waleed-iftikhar/Baby-stroller-using-PIC-16F877a-microcontroller/README.txt

Goal of this project is make baby strollers intelligent.

Functionality

	Stroller senses the presence of stroller driver (parents / supervisor)
	Send status of stroller to mobile app using bluetooth
	Control brakes according to the situation.
