waleed-iftikhar/Baby-stroller-using-PIC-16F877a-microcontroller/Project_Description.docx

- High Level Block Diagram

High level block diagram describes the basic organization of the project. The process of creating the block diagram started off at multiple low level need based block diagrams. Team divided the project into four sections, researched the types of interface needed for each section. After each diagram, all the block diagrams were combined into a high level block diagram, shown in Figure 5. It helped in gaining insight on the project. Four sections of the project are

Inputs: It consists of Driver, Baby and Waist-belt sensors. These sensors provide input to the microcontroller.

Output: It consists of brakes that are controlled by the microcontroller.

Wireless medium: It provides connectivity between microcontroller and the smartphone.

Smartphone App: It displays the status of stroller on the smartphone.

Figure 5: High Level Block Diagram

- Detailed Design

The detailed design process behind the Intelligent Baby Stroller is discussed in details in the upcoming sections. The sections, hardware, software, and engineering analysis, are the cornerstones of the Intelligent Baby Stroller. In these sections detailed explanation of every aspect of the design is provided.

- Hardware

As illustrated in Figure 5 design team divided the project into multiple subcategories. This approach led to the successful completion of project with in the schedule. Every portion of the project is discussed in detail in the following subsections.

- Driver sensing

Flexi-force sensor is very flexible and it can be easily mounted on the handle of the stroller. Its resistance changes inversely with the applied pressure. Its resistance also changes by bending the sensing area. In the absence of any sort of force the resistance of the flexi-force sensor is greater than 10 M ohm [13]. When we mount the flexi-force sensor on the handle of the stroller, its resistance drops to the 1 M ohm. This is the inherent change in resistance of the flexi-force sensor, when mounted on the handle of the stroller. When someone places hands on the handle of the stroller, the resistance of flexi-force sensor reduces inversely with the applied pressure. Design team used this phenomenon as an advantage. The circuit of the driver sensor consists of the operational amplifier and a combination of resistors as shown in the Figure 10. In this circuit the op-amp is utilized as the comparator. It keeps check of the input voltages applied at the +ive and –ive input terminals. When the force is applied at the sensing area of the flexi-force sensor, the voltage across the +ive input terminal increases. When the voltage across +ive input terminal becomes greater than the voltage across –ive input terminal, the op-amp pulls the output pin high and vice versa. In other words, when the output of the circuit is high, it means the driver is present and when the output of the sensing circuit is low, it means the driver is absent. Two sensors are mounted on the handle of the stroller. Each sensor has its own circuit. The outputs of both op-amps is connected to the pins RB4 and RB5 of the PIC16F877A. These pins are part of PORTB of the microcontroller. These pins of microcontroller are configured as interrupts. Microcontroller responds to the every change of the input signal instantly.

Figure 10: Driver Sensing Circuit

- Baby Sensing

Design team used three Force Sensitive Resistor (FSR) for baby sensing. These sensors are mounted at the appropriate places on the seat of the stroller. Circuit of the baby sensing circuit is shown in the Figure 11. Output of the baby sensing circuit is treated as the analogue signal. As the force applied to the sensing area of the FSR is increased the output voltage of the baby sensing circuit increases. The output voltages of the baby sensing circuit are fed to the Analogue to Digital converting (ADC) Port of the microcontroller. Microcontroller reads the output of every sensor after a short time interval and makes decision accordingly about the presence of baby.

Figure 11: Baby Sensing Circuit

- Waist Belt sensing

Design team came up with the very smart, simple and cost effective idea for sensing the status of waist belt. Waist belt sensing circuit consists of a push button and a resistor as shown in Figure 12 Push button is mounted inside the buckle of the waist belt. When the waist belt is locked, push button is in closed condition and the output is high signal. When the waist belt is open, push button is in the open condition and output is low signal. Both the high and low signals contain information. So team decided to keep track of the signal. The output of the waist belt sensor is connected to the “Signal Change Interrupt” of the microcontroller, just like the driver sensing.

Figure 12: Waist Belt Sensing Circuit

- Brakes

Design team spent a lot of time to come up with the economical and power efficient braking mechanism. The team analyzed the manual braking mechanism of the stroller and decided to manipulate it electronically. In this way cost can be reduced. The inner side of the stroller’s wheel is specially designed. Wheel has inner linings that are separated by angle 45o. When we apply brakes the wedge shaped plastic body gets stuck between the inner linings of the wheels thus restricting the movement of wheels. The team decided to use geared DC motors [16] along with the limit switches to control the movement of the wedge shaped body. Braking mechanism is illustrated in Figure 13.

Figure 13: Braking Mechanism

A pair of limit switches play very important role in controlling the rotation of motor. They act as feedback and inform the microcontroller about the status of brakes. It is illustrated in Figure 14. There are two limit switches for each wheel. One is limit switch senses that the brake is locked or not and other limit switch senses that the brake has properly unlocked or not.

Figure 14: Limit Switch Mechanism

Design Team used the L298 chip to control the direction of rotation of the motors. It is dual H-bridge IC. It is a high voltage, high current dual full-bridge driver designed to accept standard TTL logic levels and drive inductive loads such as relays, solenoids, DC and stepping motors. Two enable inputs are provided to enable or disable the device independently of the input signals [15]. Circuit of L298 is shown in the Figure 15. Design team was very concerned about the back emf phenomenon because motors operate in both directions, possibly at high switching rate. In order to counter the back emf, team used 1N4004 diodes in the circuit. These diodes can withstand large reverse voltages and have very high switching speed [24].

Designed braking mechanism has following features,

- It can be operated at 6-12VDC.
- Economical and components are easily available.
- It consumes very low electrical power. Thus increasing the life cycle of battery.
- It needs electric current only when brakes are to be locked or unlocked.

Figure 15: Motor Driver Circuit

- Power supply

The designed circuit operates at two different voltage levels. Microcontroller and sensors are operating at 5V, whereas the motor driver circuit needs more than 6V to operate normally. In order to resolve this issue, design team decided to use 5V voltage regulator LM7805. It can deliver up to 1.5 A of output current. The internal current-limiting and thermal-shutdown features of these regulators essentially make them immune to overload. It has internal short circuit current limiting and high power dissipation capabilities. [17]. Pin diagram of LM7805 is shown in the Figure 16.

Figure 16: Pin Diagram of LM7805

Noise is the inherent feature of a system, especially in the motor driving circuit. As a result, system cannot generate the desired results. Design team used 47uF capacitors to reduce the circuit noise. Whole circuit operates at the DC voltage and it is supplied by the battery. If battery terminals are reversed, it can damage the whole circuit. In order to reduce this potential threat, design team used diode in series with the battery to prevent the potential damage to the circuit. The power supply circuit is shown in the Figure 17.

Figure 17: Power Supply

- Bluetooth

Design team studied a lot of low power transceivers and found Bluetooth to be most appropriate for the project. This Project demands a reliable connection over a relatively long distance between the stroller and the smartphone. Because the project can be used at the crowdie places like shopping malls, streets or public parks and stroller can lose its connection with the smartphone. Thus raising the uncertainty in the system. There are many Bluetooth modules available in the market. Team did a detailed analysis and found “Bluetooth Gold Mate” module to be most suitable for the project. Schematic of Bluetooth Gold Mate is shown in Figure 18. Some of the features [18] of Bluetooth Gold Mate module are listed below.

- FCC Approved Class 1 Bluetooth Radio Modem
- Very robust link both in integrity and transmission distance (100m)
- Low power consumption : 25mA avg
- Hardy frequency hopping scheme - operates in harsh RF environments like WiFi, 802.11g, and Zigbee
- Encrypted connection
- Operating Voltage: 3.3V-6V
- Serial communications: 2400-115200bps
- Operating Temperature: -40 ~ +70C
- Built-in antenna

Bluetooth Gold Mate module communicates serially with the microcontroller at very high baud rate. Thus reducing the software burden to handle the Bluetooth module.

Figure 18: Schematic of Bluetooth Gold Mate

- Complete Circuit Diagram

Design team studied the interface circuit of the PIC16F877A microcontroller from the book [19] and used Pspice software to build the circuit diagram. Few LEDs are included in the circuit to visualize its performance. Complete circuit diagram is shown in Figure 19.

Figure 19: Complete Circuit Diagram

- Software

Development of Intelligent Baby Stroller (IBS) prototype required the programming PIC16F877A microcontroller and the development of an Android application. The following subsections explain and summarize the Code of PIC16F877A microcontroller and Android application.

- Programming PIC16F877A

The software for the PIC16F877A is developed in the software named “MikroC for PIC”. It is a full-featured ANSI C compiler for PIC devices from Microchip. It is the best solution for developing code for PIC devices. It features intuitive IDE, powerful compiler with advanced optimizations, lots of hardware and software libraries that are very helpful in work [19] [20]. Design team used modular approach to complete project on time. Team divided project into small sections. Each section was designed, debugged and tested separately. At the end all sections were combined at one place.

- Module for Driver Sensing

A module was developed in which PIC16F877A microcontroller read the output of driver sensing circuit and illustrated the results by turning on or off an LED. Output of driver sensing circuit was treated as an interrupt. The flow chart for driver sensing module is shown in the Figure 22

Figure 22: Flow Chart for Driver Sensing

- Module for Baby sensing and Bluetooth

A module was developed in which PIC16F877A microcontroller used polling technique to read the analog output of baby sensing circuit, connected to its ADC port. Microcontroller converted the analog data into digital data and sent data to the smartphone through Bluetooth using serial port. The flow chart for baby sensing module is shown in the Figure 23.

Figure 23: Flow Chart for Baby Sensing Module

- Module for Waist belt sensing

A module was developed in which PIC16F877A microcontroller read the output of waist belt sensing circuit and illustrated the results by turning on or off an LED. Output of waist belt sensing circuit was treated as an interrupt. The flow chart for driver sensing module is shown in the Figure 24.

Figure 24: Flow Chart for Waist Belt Sensing Module

- Final Prototype

Design team combined all the modules at one place and tested braking mechanism. Flow chart of software for PIC16F877A is shown in the Figure 25. Design team used polling technique to read data from the baby sensors. Outputs of the driver and waist belt sensing circuits are treated as the interrupts. These are connected to PORTB change interrupts. Whenever signals coming from the driver and waist belt sensors change their state an interrupt is generated and microcontroller moves to the interrupt service routine to take appropriate actions.

Figure 25: Flow Chart of Software for PIC16F877A

- Android Application Development

Android application is developed using Android SDK, Eclipse IDE, and ADT Plugin [21]. Layout of the android application is very simple and user friendly. Flow of Android application is illustrated in the Figure 26. Guidelines to use Android Application for Intelligent Baby Stroller are,

- Pair the Smartphone with the Bluetooth of Intelligent Baby Stroller (IBS). Default password of IBS Bluetooth is “1234”.
- Open the Android Application.
- App will ask to turn on the Bluetooth, if the Bluetooth is off.
- Window will display the paired Bluetooth connections.
- Select the Bluetooth of IBS.
- After successful connection, the screen displaying the status of the stroller will appear.

Figure 26: Flow of Android Application

Status of the Intelligent Baby Stroller is continuously illustrated on the Screen of Smartphone. Icons change their color depending on the received data. Details of the icons are depicted in the Figure 27.

Figure 27: Details of Icons

The flow chart of smartphone application code is illustrated in the Figure 28.

Figure 28: Flow Chart for Smartphone Application

- Engineering Analysis and Calculations

Design team is very skillful and possess sound electrical engineering knowledge. The collective wisdom of the team lead to the successful development of Intelligent Baby Stroller (IBS). Design team employed circuit designing and analyzing skills to select appropriate components and developed a power efficient system. Knowledge gained from the classroom was not enough for the development of Intelligent Baby Stroller. Team gained a lot of knowledge from other sources during the project development. The C language programming skills and knowledge of microcontrollers helped in the selection of appropriate C compiler for the PIC16F877A microcontroller.

- Calculations for Driver Sensing

This section deals with the offset voltage and resistance calculations for the driver sensing circuit. Sketch of Driver sensing circuit is shown in the Figure 29.

Figure 29: Sketch of Driver Sensing Circuit

The resistance of flexi sensor in the idle state is greater than 10 MΩ

Resistance of flexi sensor after mounting on the handle of the stroller = 1.6 MΩ

Offset voltage appearing at the –ive input terminal of LM324 is

By putting values we get,

Resistance can be calculated by using

After solving this equation,

When the driver places hands on the flexi sensor its resistance becomes less than the1.6 MΩ and the voltage across the +ive terminal of LM324 becomes greater than as a result output of the circuit becomes high.

- Calculations for baby sensing

The average weight of a 1 year old baby is about 20 pounds. Team was aware of the fact that the whole weight of baby will not be on the sensors. So we placed three sensors in the seat and set the limit of minimum force of 1kg for the presence of baby in the stroller.

Logarithmic plot of Force vs resistance of Force Sensitive Resistor (FSR) is shown in the Figure 30. From this plot it can be inferred that the FSR sensor acts as an open switch in the absence of force [12]. The resistance of the FSR sensor decreases with the application of force.

Figure 30: Resistance vs Force Graph of FSR Sensor

When the force of 1 kg is applied to the sensor, the resistance becomes almost equal to 1 kΩ.

For this data the voltage read by the microcontroller is given by

So the limit voltage set in the code for baby sensing is

- Power Calculations

Almost all the components are connected to microcontroller and controlled by the microcontroller. So we can perform calculations according to electrical characteristics of the microcontroller. Some important electrical characteristics of PIC16F877A are [14],

Maximum current sunk by PORTA, PORTB and PORTE (combined) = 200mA

Maximum current sourced by PORTA, PORTB and PORTE (combined) = 200mA

Maximum current sunk by PORTC and PORTD (combined) = 200mA

Maximum current sourced by PORTC and PORTD (combined) = 200mA

Since PORTE and few pins of PORTA are not being used. So we can consider that the current sourced / sunk by PORTA and PORTB (combined) is

Similarly, few pins of the PORTC and PORTD are not being used in the circuit, so we can consider that the current sourced / sunk by PORTC and PORTD (combined) is

Power dissipated in the microcontroller circuit is =

The LM7805 5V regulator consumes a total power

The Bluetooth module consumes average power

Power dissipated the motors and motors driving circuit

As motors will not be active all the time, we can omit the power dissipated by the motors in calculating the discharge time of the battery. A 7.2V 1.6Ah rechargeable NiMH high discharge battery was selected to power the circuit of Intelligent Baby Stroller (IBS). The maximum operation time of IBS circuit is,

- Data Encoding

Design team used only one byte to send complete information of the stroller. A byte contains encoded information of status of stroller. The android application decodes this information and displays it on the smartphone. Project requirement is to share the status of Brakes, waist belt, Driver sensor and Baby sensor with the smartphone. Team assigned one bit to each of them. A byte consists of two nibbles. Team used the lower nibble for data representation and placed fix data in the upper nibble. Structure of the byte is displayed in the Figure 31.

Figure 31: Structure of Byte

bit 7 - 4 X: Don’t care

bit 3 L: Status of Brake

1 = Brakes applied

0 = Brakes released

bit 2 W: Status of Waist belt

1 = Waist belt locked

0 = Waist belt open

bit 1 B: Status of Baby

1 = Baby is in the stroller

0 = Baby is not in the stroller

bit 0 D: Status of Driver

1 = Driver is present

0 = Driver is absent

There will be 16 possible combinations of the data. This data is represented in the form of characters by placing 0x4 in the upper nibble of the byte. Data contained in the byte and the resulting characters as listed in the Table 2.

Table 2: Truth Table for Data Representation

Don’t Care | | | | Data | | | | Resulting Character
X | X | X | X | L | W | B | D
0 | 1 | 0 | 0 | 0 | 0 | 0 | 0 | `
0 | 1 | 0 | 0 | 0 | 0 | 0 | 1 | a
0 | 1 | 0 | 0 | 0 | 0 | 1 | 0 | b
0 | 1 | 0 | 0 | 0 | 0 | 1 | 1 | c
0 | 1 | 0 | 0 | 0 | 1 | 0 | 0 | d
0 | 1 | 0 | 0 | 0 | 1 | 0 | 1 | e
0 | 1 | 0 | 0 | 0 | 1 | 1 | 0 | f
0 | 1 | 0 | 0 | 0 | 1 | 1 | 1 | g
0 | 1 | 0 | 0 | 1 | 0 | 0 | 0 | h
0 | 1 | 0 | 0 | 1 | 0 | 0 | 1 | i
0 | 1 | 0 | 0 | 1 | 0 | 1 | 0 | j
0 | 1 | 0 | 0 | 1 | 0 | 1 | 1 | k
0 | 1 | 0 | 0 | 1 | 1 | 0 | 0 | l
0 | 1 | 0 | 0 | 1 | 1 | 0 | 1 | m
0 | 1 | 0 | 0 | 1 | 1 | 1 | 0 | n
0 | 1 | 0 | 0 | 1 | 1 | 1 | 1 | O

There are many combinations that are not possible due to the project requirements for example it is not possible that in the presence of driver (D = 1) brakes remain active/locked (L = 1) or in the absence of driver (D = 0) brakes are not active/locked (L = 0). Design team reduced the combination table. This approach resulted in the optimized code both for the microcontroller and the android application. The reduced character set is listed in the Table 3.

Table 3: Reduced Truth Table for Data Representation

Don’t Care | | | | Data | | | | Resulting Character
X | X | X | X | L | W | B | D
0 | 1 | 0 | 0 | 0 | 0 | 0 | 1 | a
0 | 1 | 0 | 0 | 0 | 0 | 1 | 1 | c
0 | 1 | 0 | 0 | 0 | 1 | 0 | 1 | e
0 | 1 | 0 | 0 | 0 | 1 | 1 | 1 | g
0 | 1 | 0 | 0 | 1 | 0 | 0 | 0 | h
0 | 1 | 0 | 0 | 1 | 0 | 1 | 0 | j
0 | 1 | 0 | 0 | 1 | 1 | 0 | 0 | l
0 | 1 | 0 | 0 | 1 | 1 | 1 | 0 | n
