waleed-iftikhar/Baby-stroller-using-PIC-16F877a-microcontroller/(list of files, drawings)

Other design files:
ADC.DSN
